I-STAR/HARP/README.md

# HARP
A 3D-printable phantom for axial MTF measurements in CT
