I-STAR/HARP/SolidWorks Parts/Column_1.6_10cm.SLDPRT

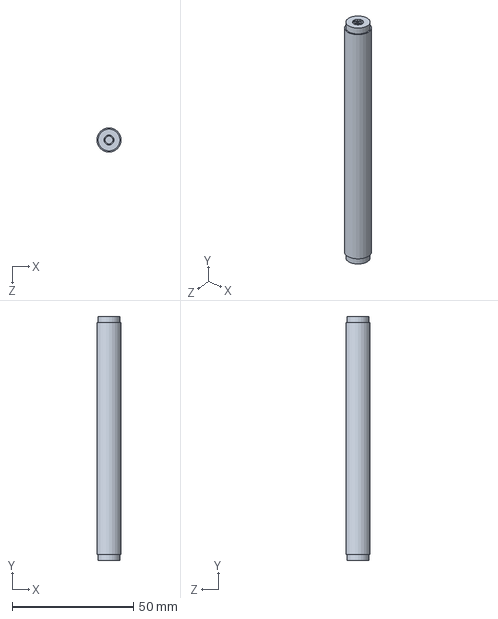
[picture p14: CAD file, 2022-06-02]
SolidWorks Parts/Column_1.6_10cm.SLDPRT
10.0 x 100.5 x 10.0 mm
