I-STAR/HARP/SolidWorks Parts/InnerPost_1.6_10cm.SLDPRT

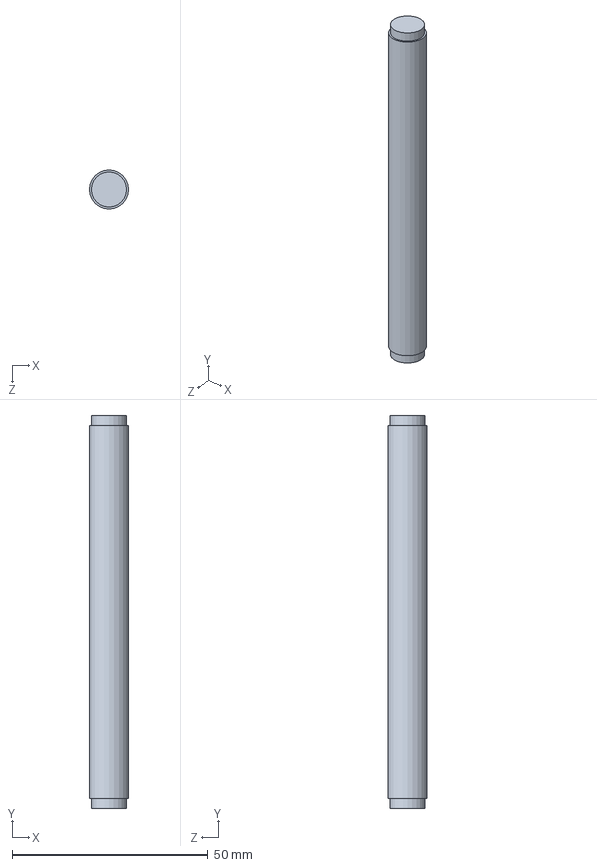
[picture p15: CAD file, 2022-06-02]
SolidWorks Parts/InnerPost_1.6_10cm.SLDPRT
10.0 x 100.5 x 10.0 mm
