I-STAR/HARP/SolidWorks Parts/Column_1.6_3cm.SLDPRT

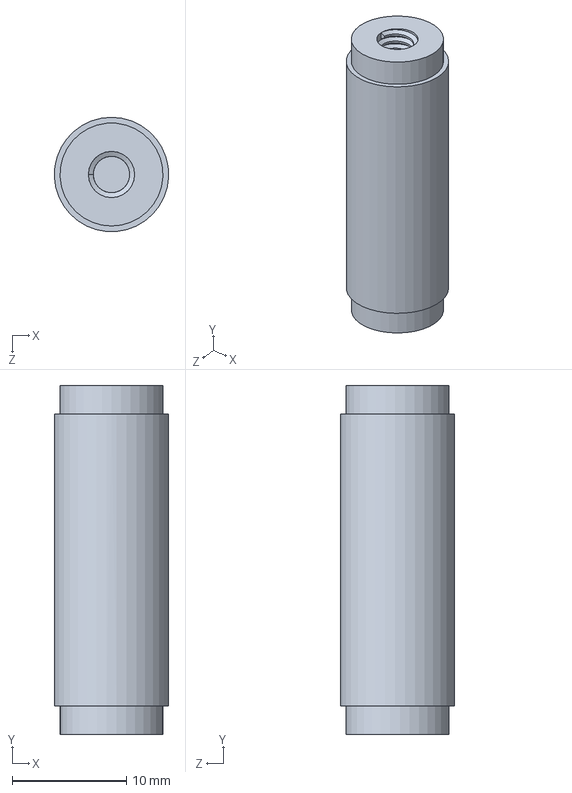
[picture p16: CAD file, 2022-06-02]
SolidWorks Parts/Column_1.6_3cm.SLDPRT
9.99 x 30.5 x 10.0 mm
