I-STAR/HARP/SolidWorks Parts/Top_Plate_1.6.SLDPRT

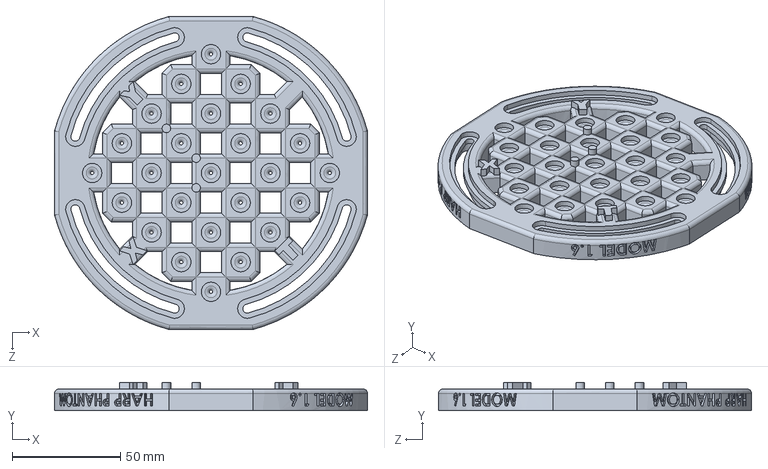
[picture p19: CAD file, 2022-06-02]
SolidWorks Parts/Top_Plate_1.6.SLDPRT
144.9 x 13.0 x 144.9 mm
