I-STAR/HARP/SolidWorks Parts/Bottom_Plate_1.6.SLDPRT

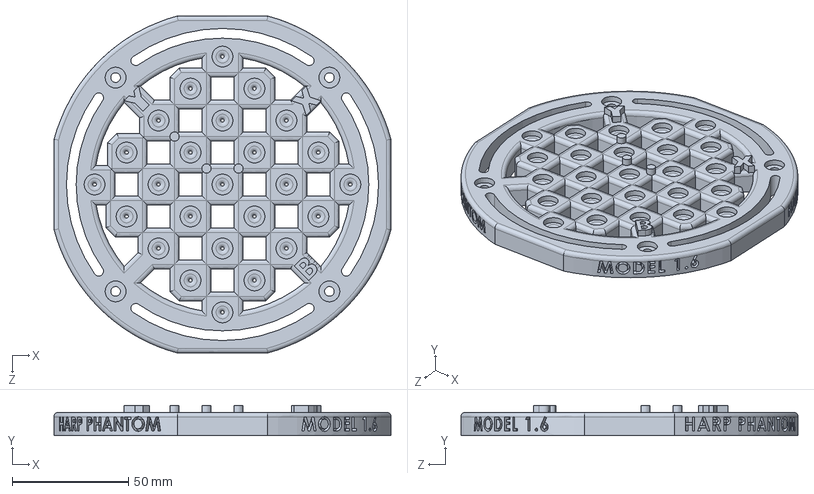
[picture p20: CAD file, 2022-06-02]
SolidWorks Parts/Bottom_Plate_1.6.SLDPRT
144.9 x 13.0 x 144.9 mm
