I-STAR/HARP/SolidWorks Parts/Column_1.6_6cm.SLDPRT

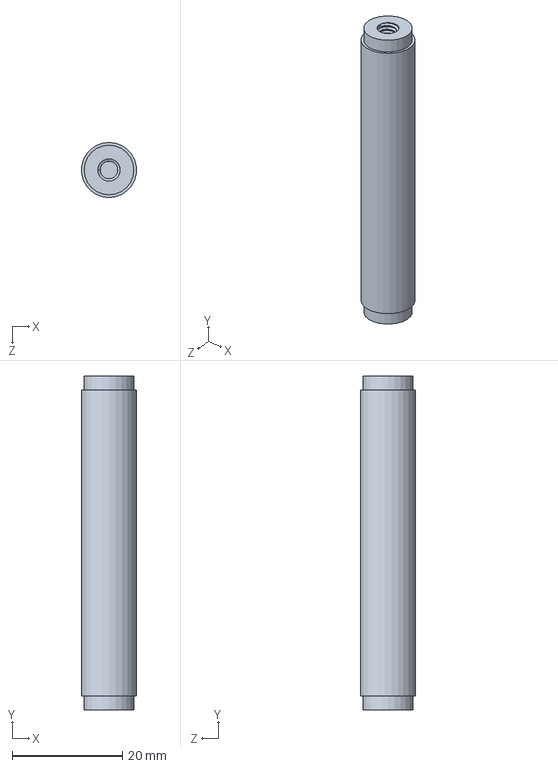
[picture p21: CAD file, 2022-06-02]
SolidWorks Parts/Column_1.6_6cm.SLDPRT
9.93 x 60.5 x 10.0 mm
