I-STAR/HARP/(list of files, cad)

Other CAD files:
STLs/InnerPost_1.6_10cm.STL
STLs/InnerPost_1.6_3cm.STL
STLs/InnerPost_1.6_6cm.STL
